Lone-Jade/My_IntegratedDesignAndPractice_A/Model_v2/artifacts/confusion_matrix.png

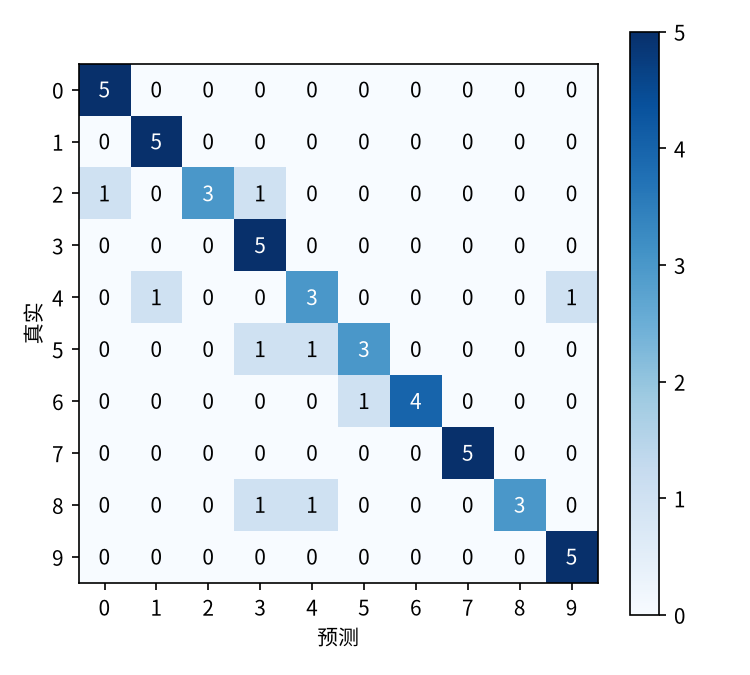
Model_v2/artifacts/confusion_matrix.png
