Lone-Jade/My_IntegratedDesignAndPractice_A/Model_v2/artifacts/curves.png

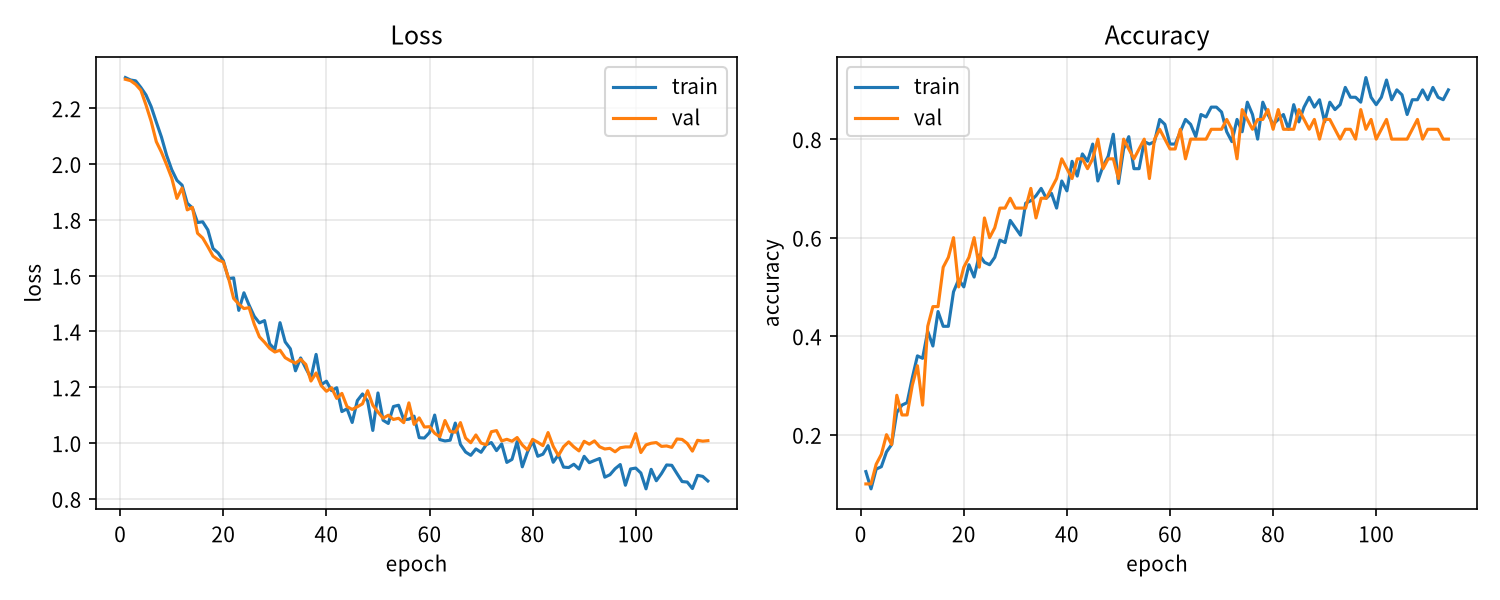
Model_v2/artifacts/curves.png
