Lone-Jade/My_IntegratedDesignAndPractice_A/Model_v2/artifacts/preprocess_grid.png

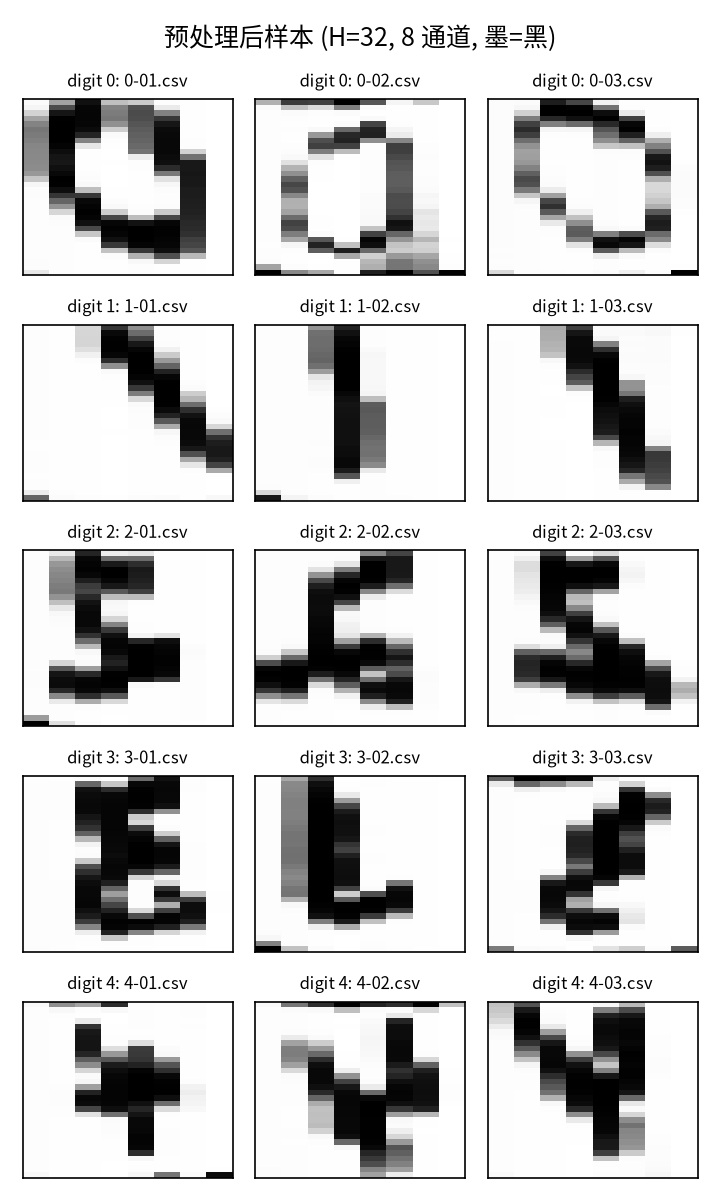
Model_v2/artifacts/preprocess_grid.png
