Lone-Jade/My_IntegratedDesignAndPractice_A/video/results.xlsx

 | x-20 |  | x-30
 | 第一次 | 第二次 | 第一次 | 第二次
0 | 0 | - | 0 | -
1 | 1 | - | 1 | -
2 | 2 | - | 2 | -
3 | 3 | - | 8 | 3
4 | 4 | - | 2 | 4
5 | 5 | - | 5 | -
6 | 6 | - | 6 | -
7 | 9 | 7 | 7 | -
8 | 8 | - | 9 | 8
9 | 3 | 9 | 8 | 9
