Lone-Jade/My_IntegratedDesignAndPractice_A/Kicad/AI_PCB_SCH.kicad_pcb

## KiCad design Kicad/AI_PCB_SCH.kicad_pcb (2026-08-28)

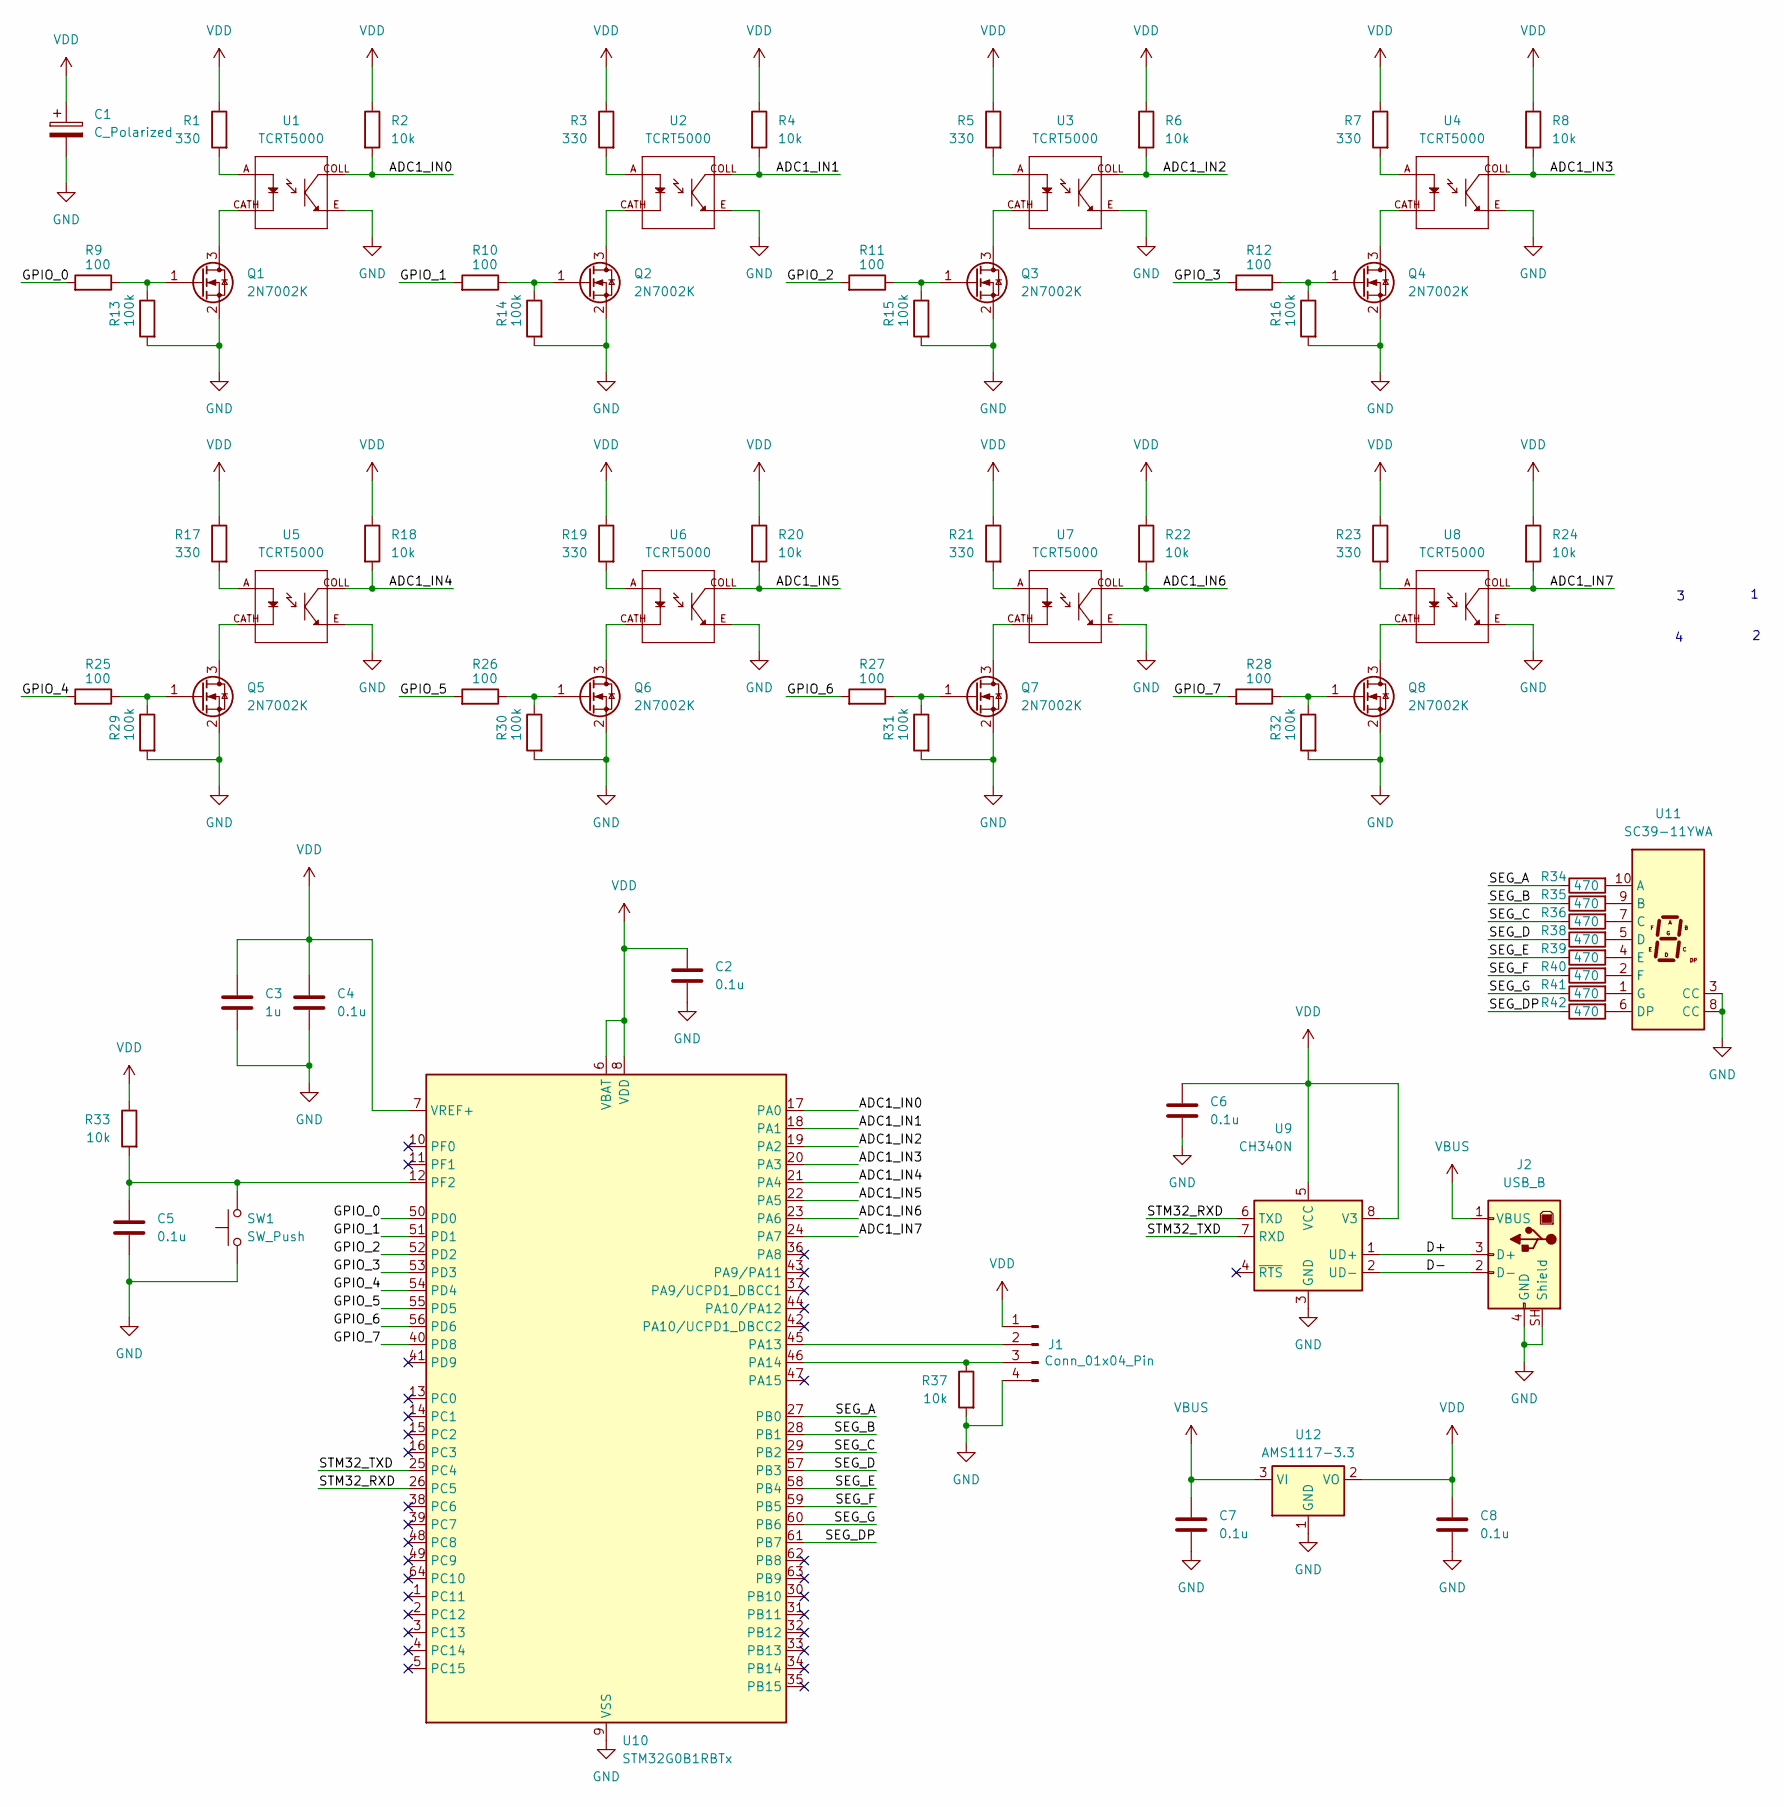
[picture p4: schematic AI_PCB_SCH.kicad_sch]

Parts:
C1: C_Polarized; CP_Radial_D5.0mm_P2.00mm
C2, C4, C5, C6, C7, C8: 0.1u; C_0805_2012Metric_Pad1.18x1.45mm_HandSolder
C3: 1u; C_0805_2012Metric_Pad1.18x1.45mm_HandSolder
J1: Conn_01x04_Pin; PinHeader_1x04_P2.54mm_Vertical
J2: USB_B; USB_B_Lumberg_2411_02_Horizontal
Q1, Q2, Q3, Q4, Q5, Q6, Q7, Q8: 2N7002K; SOT-23_Handsoldering
R1, R3, R5, R7, R17, R19, R21, R23: 330; R_0805_2012Metric_Pad1.20x1.40mm_HandSolder
R2, R4, R6, R8, R18, R20, R22, R24, R33, R37: 10k; R_0805_2012Metric_Pad1.20x1.40mm_HandSolder
R9, R10, R11, R12, R25, R26, R27, R28: 100; R_0805_2012Metric_Pad1.20x1.40mm_HandSolder
R13, R14, R15, R16, R29, R30, R31, R32: 100k; R_0805_2012Metric_Pad1.20x1.40mm_HandSolder
R34, R35, R36, R38, R39, R40, R41, R42: 470; R_0805_2012Metric_Pad1.20x1.40mm_HandSolder
SW1: SW_Push; SW_PUSH_6mm
U1, U2, U3, U4, U5, U6, U7, U8: TCRT5000; OPTO_TCRT5000; PARTREV 1.7
U9: CH340N; JEITA_SOIC-8_3.9x4.9mm_P1.27mm
U10: STM32G0B1RBTx; LQFP-64_10x10mm_P0.5mm
U11: SC39-11YWA; Sx39-1xxxxx
U12: AMS1117-3.3; SOT-223-3_TabPin2

Connections:
/ADC1_IN0: R2.2, U1.COLL, U10.17 (PA0)
/ADC1_IN1: R4.2, U2.COLL, U10.18 (PA1)
/ADC1_IN2: R6.2, U3.COLL, U10.19 (PA2)
/ADC1_IN3: R8.2, U4.COLL, U10.20 (PA3)
/ADC1_IN4: R18.2, U5.COLL, U10.21 (PA4)
/ADC1_IN5: R20.2, U6.COLL, U10.22 (PA5)
/ADC1_IN6: R22.2, U7.COLL, U10.23 (PA6)
/ADC1_IN7: R24.2, U8.COLL, U10.24 (PA7)
/D+: J2.3 (D+), U9.1 (UD+)
/D-: J2.2 (D-), U9.2 (UD-)
/GPIO_0: R9.2, U10.50 (PD0)
/GPIO_1: R10.2, U10.51 (PD1)
/GPIO_2: R11.2, U10.52 (PD2)
/GPIO_3: R12.2, U10.53 (PD3)
/GPIO_4: R25.2, U10.54 (PD4)
/GPIO_5: R26.2, U10.55 (PD5)
/GPIO_6: R27.2, U10.56 (PD6)
/GPIO_7: R28.2, U10.40 (PD8)
/SEG_A: R34.1, U10.27 (PB0)
/SEG_B: R35.1, U10.28 (PB1)
/SEG_C: R36.1, U10.29 (PB2)
/SEG_D: R38.1, U10.57 (PB3)
/SEG_DP: R42.1, U10.61 (PB7)
/SEG_E: R39.1, U10.58 (PB4)
/SEG_F: R40.1, U10.59 (PB5)
/SEG_G: R41.1, U10.60 (PB6)
/STM32_RXD: U9.6 (TXD), U10.26 (PC5)
/STM32_TXD: U9.7 (RXD), U10.25 (PC4)
GND: C1.2, C2.2, C3.2, C4.2, C5.2, C6.2, C7.2, C8.2, J1.4, J2.4 (GND), J2.SH (Shield), Q1.2 (S), Q2.2 (S), Q3.2 (S), Q4.2 (S), Q5.2 (S), Q6.2 (S), Q7.2 (S), Q8.2 (S), R13.2, R14.2, R15.2, R16.2, R29.2, R30.2, R31.2, R32.2, R37.2, SW1.1, U1.E, U2.E, U3.E, U4.E, U5.E, U6.E, U7.E, U8.E, U9.3 (GND), U10.9 (VSS), U11.3 (CC), U11.8 (CC), U12.1 (GND)
unnamed: J1.2, U10.45 (PA13)
unnamed: J1.3, R37.1, U10.46 (PA14)
unnamed: Q1.3 (D), U1.CATH
unnamed: Q1.1 (G), R9.1, R13.1
unnamed: Q2.3 (D), U2.CATH
unnamed: Q2.1 (G), R10.1, R14.1
unnamed: Q3.3 (D), U3.CATH
unnamed: Q3.1 (G), R11.1, R15.1
unnamed: Q4.3 (D), U4.CATH
unnamed: Q4.1 (G), R12.1, R16.1
unnamed: Q5.3 (D), U5.CATH
unnamed: Q5.1 (G), R25.1, R29.1
unnamed: Q6.3 (D), U6.CATH
unnamed: Q6.1 (G), R26.1, R30.1
unnamed: Q7.3 (D), U7.CATH
unnamed: Q7.1 (G), R27.1, R31.1
unnamed: Q8.3 (D), U8.CATH
unnamed: Q8.1 (G), R28.1, R32.1
unnamed: R1.2, U1.A
unnamed: R3.2, U2.A
unnamed: R5.2, U3.A
unnamed: R7.2, U4.A
unnamed: R17.2, U5.A
unnamed: R19.2, U6.A
unnamed: R21.2, U7.A
unnamed: R23.2, U8.A
unnamed: C5.1, R33.2, SW1.2, U10.12 (PF2)
unnamed: R34.2, U11.10 (A)
unnamed: R35.2, U11.9 (B)
unnamed: R36.2, U11.7 (C)
unnamed: R38.2, U11.5 (D)
unnamed: R42.2, U11.6 (DP)
unnamed: R39.2, U11.4 (E)
unnamed: R40.2, U11.2 (F)
unnamed: R41.2, U11.1 (G)
VBUS: C7.1, J2.1 (VBUS), U12.3 (VI)
VDD: C1.1, C2.1, C3.1, C4.1, C6.1, C8.1, J1.1, R1.1, R2.1, R3.1, R4.1, R5.1, R6.1, R7.1, R8.1, R17.1, R18.1, R19.1, R20.1, R21.1, R22.1, R23.1, R24.1, R33.1, U9.5 (VCC), U9.8 (V3), U10.6 (VBAT), U10.7 (VREF+), U10.8 (VDD), U12.2 (VO)

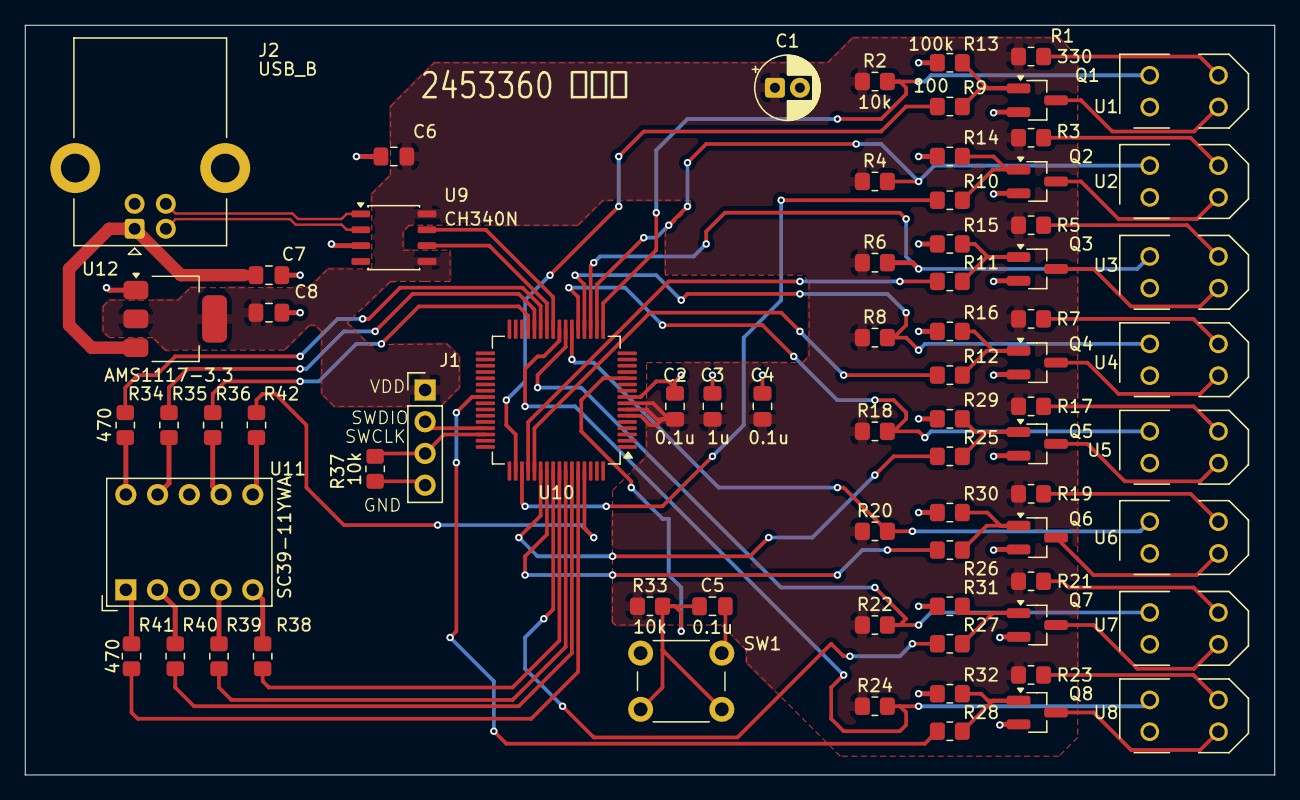
[picture p5: board AI_PCB_SCH.kicad_pcb from above]

Board: 2 copper layers, 100.0 x 60.0 mm, 73 parts (0 on the bottom side), 66 nets.
