Lone-Jade/My_IntegratedDesignAndPractice_A/AI_TCRT5000_CHAR_RECOGNITION/AI_TCRT5000_CHAR_RECOGNITION.ioc

Mcu.UserName=STM32G0B1RBTx
PA0.Signal=ADC1_IN0
PA1.Signal=ADC1_IN1
PA13.Signal=SYS_SWDIO
PA14-BOOT0.Signal=SYS_SWCLK
PA2.Signal=ADC1_IN2
PA3.Signal=ADC1_IN3
PA4.Signal=ADC1_IN4
PA5.Signal=ADC1_IN5
PA6.Signal=ADC1_IN6
PA7.Signal=ADC1_IN7
PC4.Signal=USART1_TX
PC5.Signal=USART1_RX
PD0.GPIO_Label=GPIO_0
PD0.Signal=GPIO_Output
PD1.GPIO_Label=GPIO_1
PD1.Signal=GPIO_Output
PD2.GPIO_Label=GPIO_2
PD2.Signal=GPIO_Output
PD3.GPIO_Label=GPIO_3
PD3.Signal=GPIO_Output
PD4.GPIO_Label=GPIO_4
PD4.Signal=GPIO_Output
PD5.GPIO_Label=GPIO_5
PD5.Signal=GPIO_Output
PD6.GPIO_Label=GPIO_6
PD6.Signal=GPIO_Output
PD8.GPIO_Label=GPIO_7
PD8.Signal=GPIO_Output
