Lone-Jade/My_IntegratedDesignAndPractice_A/AI_TCRT5000_CHAR_RECOGNITION/Core/Inc/main.h

#define GPIO_7_Pin GPIO_PIN_8
#define GPIO_7_GPIO_Port GPIOD
#define GPIO_0_Pin GPIO_PIN_0
#define GPIO_0_GPIO_Port GPIOD
#define GPIO_1_Pin GPIO_PIN_1
#define GPIO_1_GPIO_Port GPIOD
#define GPIO_2_Pin GPIO_PIN_2
#define GPIO_2_GPIO_Port GPIOD
#define GPIO_3_Pin GPIO_PIN_3
#define GPIO_3_GPIO_Port GPIOD
#define GPIO_4_Pin GPIO_PIN_4
#define GPIO_4_GPIO_Port GPIOD
#define GPIO_5_Pin GPIO_PIN_5
#define GPIO_5_GPIO_Port GPIOD
#define GPIO_6_Pin GPIO_PIN_6
#define GPIO_6_GPIO_Port GPIOD
