Lone-Jade/My_IntegratedDesignAndPractice_A/AI_TCRT5000_CHAR_RECOGNITION/Network/network_data.c

/**
  ******************************************************************************
  * @file    network_data.c
  * @author  AST Embedded Analytics Research Platform
  * @date    2026-08-27T12:41:52+0800
  * @brief   AI Tool Automatic Code Generator for Embedded NN computing
  ******************************************************************************
  * Copyright (c) 2026 STMicroelectronics.
  * All rights reserved.
  *
  * This software is licensed under terms that can be found in the LICENSE file
  * in the root directory of this software component.
  * If no LICENSE file comes with this software, it is provided AS-IS.
  ******************************************************************************
  */

#include "network_data.h"
STAI_ALIGNED(8)
const uint64_t g_network_weights_array[2866] = {
  0x14e4c085f9a28f81U, 0x2e22a950e4994ad0U, 0x815a66952c34fc81U, 0x814debe8d3c9ecf8U,
  0x7f9d993cf8062831U, 0xd42a003744fe0557U, 0x1e07167e36e47ff2U, 0x3ced7fbfaf51b2eaU,
  0xeb5df65607376a7fU, 0x340d00002345U, 0x177b00000702U, 0x41d00000c0dU,
  0xa01000002ccU, 0xec1f2c31fcade5e8U, 0xf7306545c540c1d2U, 0xc0dbfeec4c1737c5U,
  0x10d5421df0beefeaU, 0x397f663ebd2cbae8U, 0xcfd73e3d233c30d0U, 0x4dc3f7ec11e0dafbU,
  0x4a314334c833dcaeU, 0xf5cff33af56903e2U, 0x340436fbbe35d5b6U, 0x1b06f22f072534cbU,
  0x5203127e0301605U, 0xf5b0fbe5ea201de1U, 0x33cdfcebf8130dcaU, 0x2cee0fd062005ecU,
  0xda81c40b062c2d24U, 0xfde9ecf8edcdff27U, 0xe0d8d1ef2be5f90bU, 0x14bd2c43e9f31bdaU,
  0xfeb14bdc0bb4f90aU, 0x11d05a27babdb2e8U, 0x141e1f41d818c625U, 0x19cb433c12c9c00eU,
  0x45d4f231102bbcd0U, 0x6ace140ee2dcacd8U, 0x3e8111019e28e9c7U, 0x4494ec1ae9300be2U,
  0x772e637410d20d2U, 0x3f94fd4a58cb0135U, 0xe07a6604d6fae632U, 0xe010a4f27e3cee5U,
  0x5ebc3702061811e8U, 0x16ef4012a2188ec5U, 0x10a1f813b2c9bcc4U, 0x6b9f1ed0ddcefcbeU,
  0x4dc3017907fc1e4U, 0x2bf109153c4e3c2dU, 0xe781f51533cc033eU, 0x159ab6c60ea2f741U,
  0x1007f744f6001019U, 0xc9d3f90f1edb012fU, 0xcacd02d73fd02867U, 0xf0d8086131fc1e19U,
  0xf3ddf22e36d6344aU, 0xc3a0d8f8220e3b60U, 0xe93a06b807d649a3U, 0xf059323ace22e3d0U,
  0xac7f5f110e22d04U, 0x261fd4c800fe059fU, 0x1f741a28d30bdbe1U, 0xd89bcb3f4aea37cbU,
  0xfd38e5f404120cebU, 0xe97f5032d72503bdU, 0xfce60e12241d3a04U, 0x3ce93d0a00f5ffe4U,
  0x4bb40512ee09c6f0U, 0x1cde43f5ddf9aec7U, 0x38cc3f37d30918c4U, 0x52f8ef351fe4d004U,
  0x2fc112d6001ddde7U, 0x4ff4e005f0eefbf8U, 0x33caeaedfaeed7daU, 0x1481f911bf1324d0U,
  0x21902cc381c1cc9U, 0x11442cf4f7260fafU, 0xfffbda31380934c5U, 0x25f7badc142438daU,
  0xe57a22e8db1adcbdU, 0xd6ff0300091f44cdU, 0xf0c901e5242b55c1U, 0xe87f29f3d3f0fafeU,
  0xe1d6ff33362641d3U, 0xc7f3502ee39ddefU, 0x7c4d2ff3cf21e1eU, 0xff0dddb7e5a2d507U,
  0x2f734835db2302b3U, 0xe7c1ed3349111ec1U, 0xef0c10c60edbef2eU, 0xb5d4024a851cdbaU,
  0xfff0244491a2cd8U, 0x310febf421b0e314U, 0xb605b3050c0026e1U, 0xe17f05ed42fb17d4U,
  0x39673522ee0b0fe6U, 0xd002e7131d1617dbU, 0x294b24cc080302b5U, 0x444f2df1de18f7c7U,
  0xe4f5f5ee25ef1d19U, 0x282d33d7f828dbb0U, 0x2d12480ef933f6ddU, 0xfed7ef1048cb53c6U,
  0xf72f0e260235fe0fU, 0xe8caf8fa15180001U, 0xdfb0d72326fd5fb3U, 0xf47844d4e42a04ddU,
  0xddc2e82a35cd36dbU, 0xdff1bce610fd55d0U, 0x7f1ceccbf8c4e6U, 0x18daff37350537caU,
  0x3b00342d1fad37a9U, 0xc0c5153ccfedda8U, 0xf81e009113c1c8fU, 0x53e80ba10ede0701U,
  0x3a99de1fcbed0b97U, 0x3e18e51d8eef028fU, 0x38032f01ed31d727U, 0x1d8e9ec954f229b9U,
  0x70ad1acf6d5f4f3U, 0xf8bc2442190c3350U, 0xbe81d0d436d81833U, 0xf1bbd5d5508f1b63U,
  0xf0c32a404700445bU, 0xf2b1e2e915d40c62U, 0x1cd2f0ed039e1e69U, 0xdbe7073615f9185bU,
  0xecd1da1a51c81a39U, 0xbe2e00222d64662U, 0x489f211221f9f0c7U, 0xffb8f7cce5d6a13dU,
  0x3602210ec616c6e9U, 0x55da3249d409decdU, 0x75810d12022a92deU, 0x34de4419df060912U,
  0x68de1a15e02ea61bU, 0xf9b14fe074cd037U, 0x5db2ff1bb6464530U, 0xd15e0d1344ca1d05U,
  0x17fdcdfd35df40f1U, 0xfbdcc2ef47f01a4cU, 0xe438c81cf90f290cU, 0xcf11e41cfafbf7fbU,
  0xf341f3eb3ccc0e4fU, 0xeb33ea3adbded906U, 0x37f585124bfb909U, 0x8706942ddfbc9bdU,
  0x4592ffdd2ff1b09U, 0xf122030f3df8182aU, 0xe2e9b2b7ef911004U, 0xff5a463bed149fc9U,
  0xf9f83b1e452949dcU, 0xf9f6d4b70ba2e60aU, 0xa7d47eb880381aeU, 0x3c24534f3e320ccbU,
  0x19fbebde08ae18e3U, 0x45800000b81U, 0x5400000ec6U, 0x16800000364U,
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
};
