Lone-Jade/My_IntegratedDesignAndPractice_A/(commit log)

2026-08-23 add Scan code
    [cmsis-debug.cfg]
2026-08-25 第一版提交归档：扫描部分文档 + 模型v1 + 单片机代码 + 数据集 + Python工具
    - AI_TCRT5000_ScanData：补充 README 与 docs（任务书/电路连接说明）
    - Model_v1：python 训练/量化脚本 + C 模型（Network + Middlewares 运行时）+ 模型产物与可行性报告
    - MCU_Code：当前完整固件（采集 + 板载 AI 推理 + 数码管显示，可构建）
    - Dataset：0~9 共 200 个扫描 CSV
    - Python_Tools：全套 10 个工具
    [0-01.csv, 0-02.csv, 0-03.csv, 0-04.csv, 0-05.csv, 0-06.csv, 0-07.csv, 0-08.csv]
2026-08-25 重命名工程为 AI_TCRT5000_ScanData：更新工程名与构建/调试配置，移除旧构建产物
2026-08-27 更新至第二版（V2）：300 样本数据集 + Model_v2 模型 + 第二轮 int8 固件
    - Dataset：新增 0~9 各 21~30 号字体版扫描 CSV（共 100 个），总数达 300 样本
    - Model_v2：新增第二轮训练/评估/量化全套（固定划分 20/5/5、5 seed 集成），
    含 int8 C 模型（ST Edge AI generate-2）、onnx/npz 产物、混淆矩阵与可行性报告
    - MCU_Code：Network 更新为第二轮 int8 网络（network.c/h、network_data.c/h、
    network_details.h），.gitignore 补充 .ai/ 与采集残留忽略规则
    - Python_Tools：新增 eval_model.py（部署模型评估）与 make_print_sheet_fonts.py
    （打印稿字体生成），更新 train_digit.py、expor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
    [0-21.csv, 0-22.csv, 0-23.csv, 0-24.csv, 0-25.csv, 0-26.csv, 0-27.csv, 0-28.csv]
2026-08-27 新增项目配置文件：添加 .mxproject、launch.json 和 settings.json 文件以支持调试和构建配置
2026-08-27 重命名工程为 AI_TCRT5000_Char_Recognition：更新 .ioc 文件名及内部 ProjectName/ProjectFileName
2026-08-27 重命名工程为 AI_TCRT5000_CHAR_RECOGNITION：MCU_Code 更名为 AI_TCRT5000_CHAR_RECOGNITION 并重建固件
    - 目录 MCU_Code → AI_TCRT5000_CHAR_RECOGNITION，.ioc 同步更名为
    AI_TCRT5000_CHAR_RECOGNITION.ioc（CubeMX 重新生成 .mxproject/main.c 等）
    - 恢复 ST Edge AI 运行时 Middlewares/ST/AI（NetworkRuntime1201_CM0+_GCC.a）
    - CMakeLists 工程名更新为 AI_TCRT5000_CHAR_RECOGNITION，
    .vscode/launch.json 调试目标同步更新
    - 已验证构建通过：FLASH 53.10% / RAM 12.04%
    [cmsis-debug.cfg]
2026-08-27 重构根目录 README：按主仓库风格详细介绍当前提交归档仓库
    - 新增系统概览（mermaid 流程图 + 各环节方案表）
    - 仓库结构总览 + 六个目录逐个详解（ScanData/Dataset/Model_v1/Model_v2/Python_Tools/固件）
    - 第一版 vs 最新版结果对比表与关键结论
    - 快速开始（构建/烧录/采集/训练/部署/查看推理）、串口协议、版本记录、与主仓库关系
2026-08-27 更新 README：修正文本中的符号和格式，确保一致性
2026-08-27 Remove unused files and linker script for STM32G0B1xx project
    - Deleted the linker script (STM32G0B1xx_FLASH.ld) as it is no longer needed.
    - Removed CMake configuration files for GCC and Clang toolchains.
    - Eliminated the STM32CubeMX generated CMakeLists.txt file.
    - Deleted CMSIS debug configuration file.
    - Removed startup assembly file (startup_stm32g0b1xx.s) for STM32G0B1xx devices.
    [cmsis-debug.cfg]
2026-08-27 添加视频结果文件 results.xlsx
    [results.xlsx]
2026-08-28 更新 README：移除关于主仓库的引用，简化提交归档说明
2026-08-28 更新 .gitignore：添加对 .mp4 文件的忽略规则
2026-08-28 更新 .gitignore：修复对 .mp4 文件的忽略规则
2026-08-28 Update documentation and structure for Model_v2 and Python_Tools
    - Revised README.md for Model_v2 to remove outdated references and clarify model deployment details.
    - Updated Python_Tools README to simplify descriptions of tools without referencing the main repository.
    - Enhanced main README.md to provide a clearer overview of the repository structure, including detailed descriptions of each directory and its contents.
    - Added new sections for Kicad hardware design files and clarified model update instructions for the AI_TCRT5000_CHAR_RECOGNITION firmware.
    [AI_PCB_SCH.kicad_pcb, AI_PCB_SCH.kicad_sch]
2026-08-28 更新 README：移除关于文档目录的描述，简化仓库结构说明
